UNCAMotorsports/TestMule/README.md

# RedBuggy
Software related to the "Red Buggy" / FSAE car for UNCA Motorsports
