UNCAMotorsports/TestMule/docs/Red Buggy Electrical Block Diagram.pdf

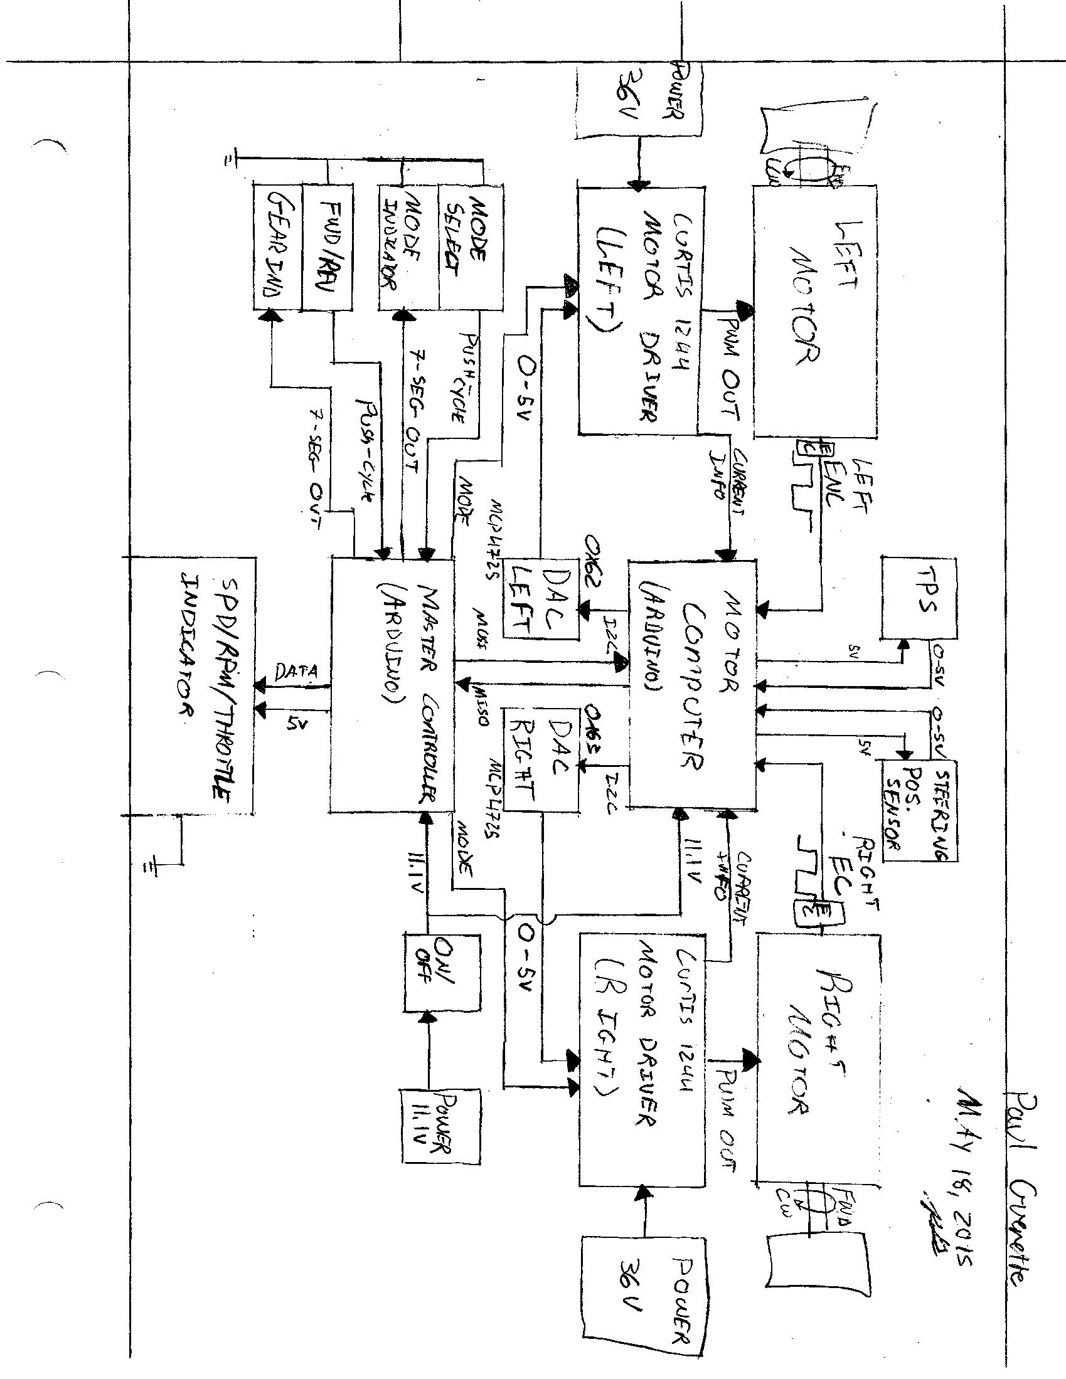
[picture p1: page 1]
