UNCAMotorsports/TestMule/schematics/Pictures/BuggyMotorBoard_Board001.png

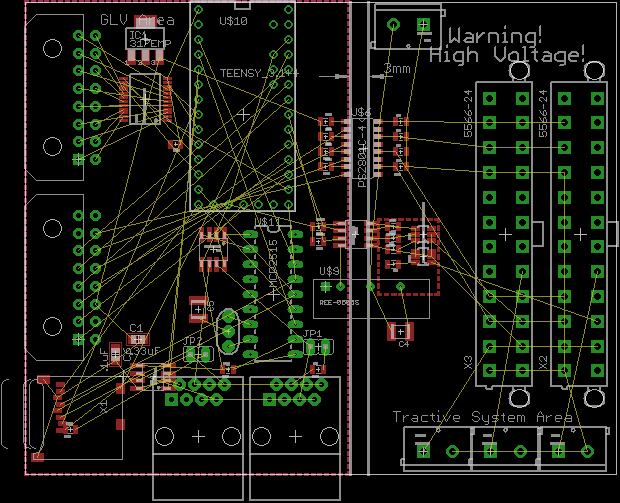
schematics/Pictures/BuggyMotorBoard_Board001.png
