UNCAMotorsports/TestMule/schematics/Pictures/BuggyMotorBoard_Schematic001.png

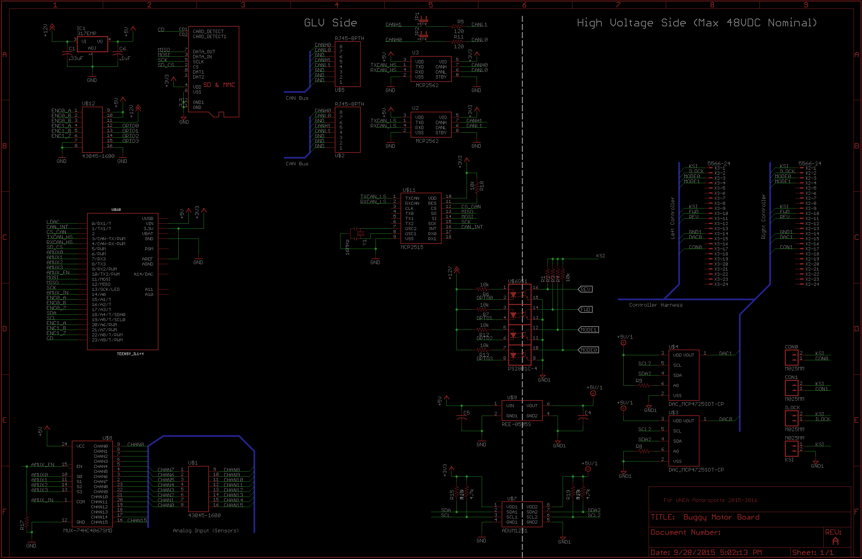
schematics/Pictures/BuggyMotorBoard_Schematic001.png
