UNCAMotorsports/TestMule/docs/Power Consumption.xlsx

 |  | Datasheet (Amps) |  | As Implemented (mA)
Part | Power Bus | Idd (Typ) | Idd (Max) | Typ | Max | Eff. Factor | Quantity
MCP4725 | 5v | 0.0002 | 0.0002 | 0.53 | 0.53 | 80% | 2
SD Card | 5v | 0.0400 | 0.1000 | 40.00 | 100.00 | 100% | 1
MCP2515 | 5v | 0.0100 | 0.0100 | 10.00 | 10.00 | 100% | 1
MCP2551 | 5v | 0.0900 | 0.0900 | 90.00 | 90.00 | 100% | 1
ADUM1251 | 5v | 0.0028 | 0.0050 | 2.80 | 5.00 | 100% | 1
Total |  | 0.1430 | 0.2052 | 143.33 | 205.53 |  | 6
