UNCAMotorsports/TestMule/schematics/Buggy Motor Board.pdf

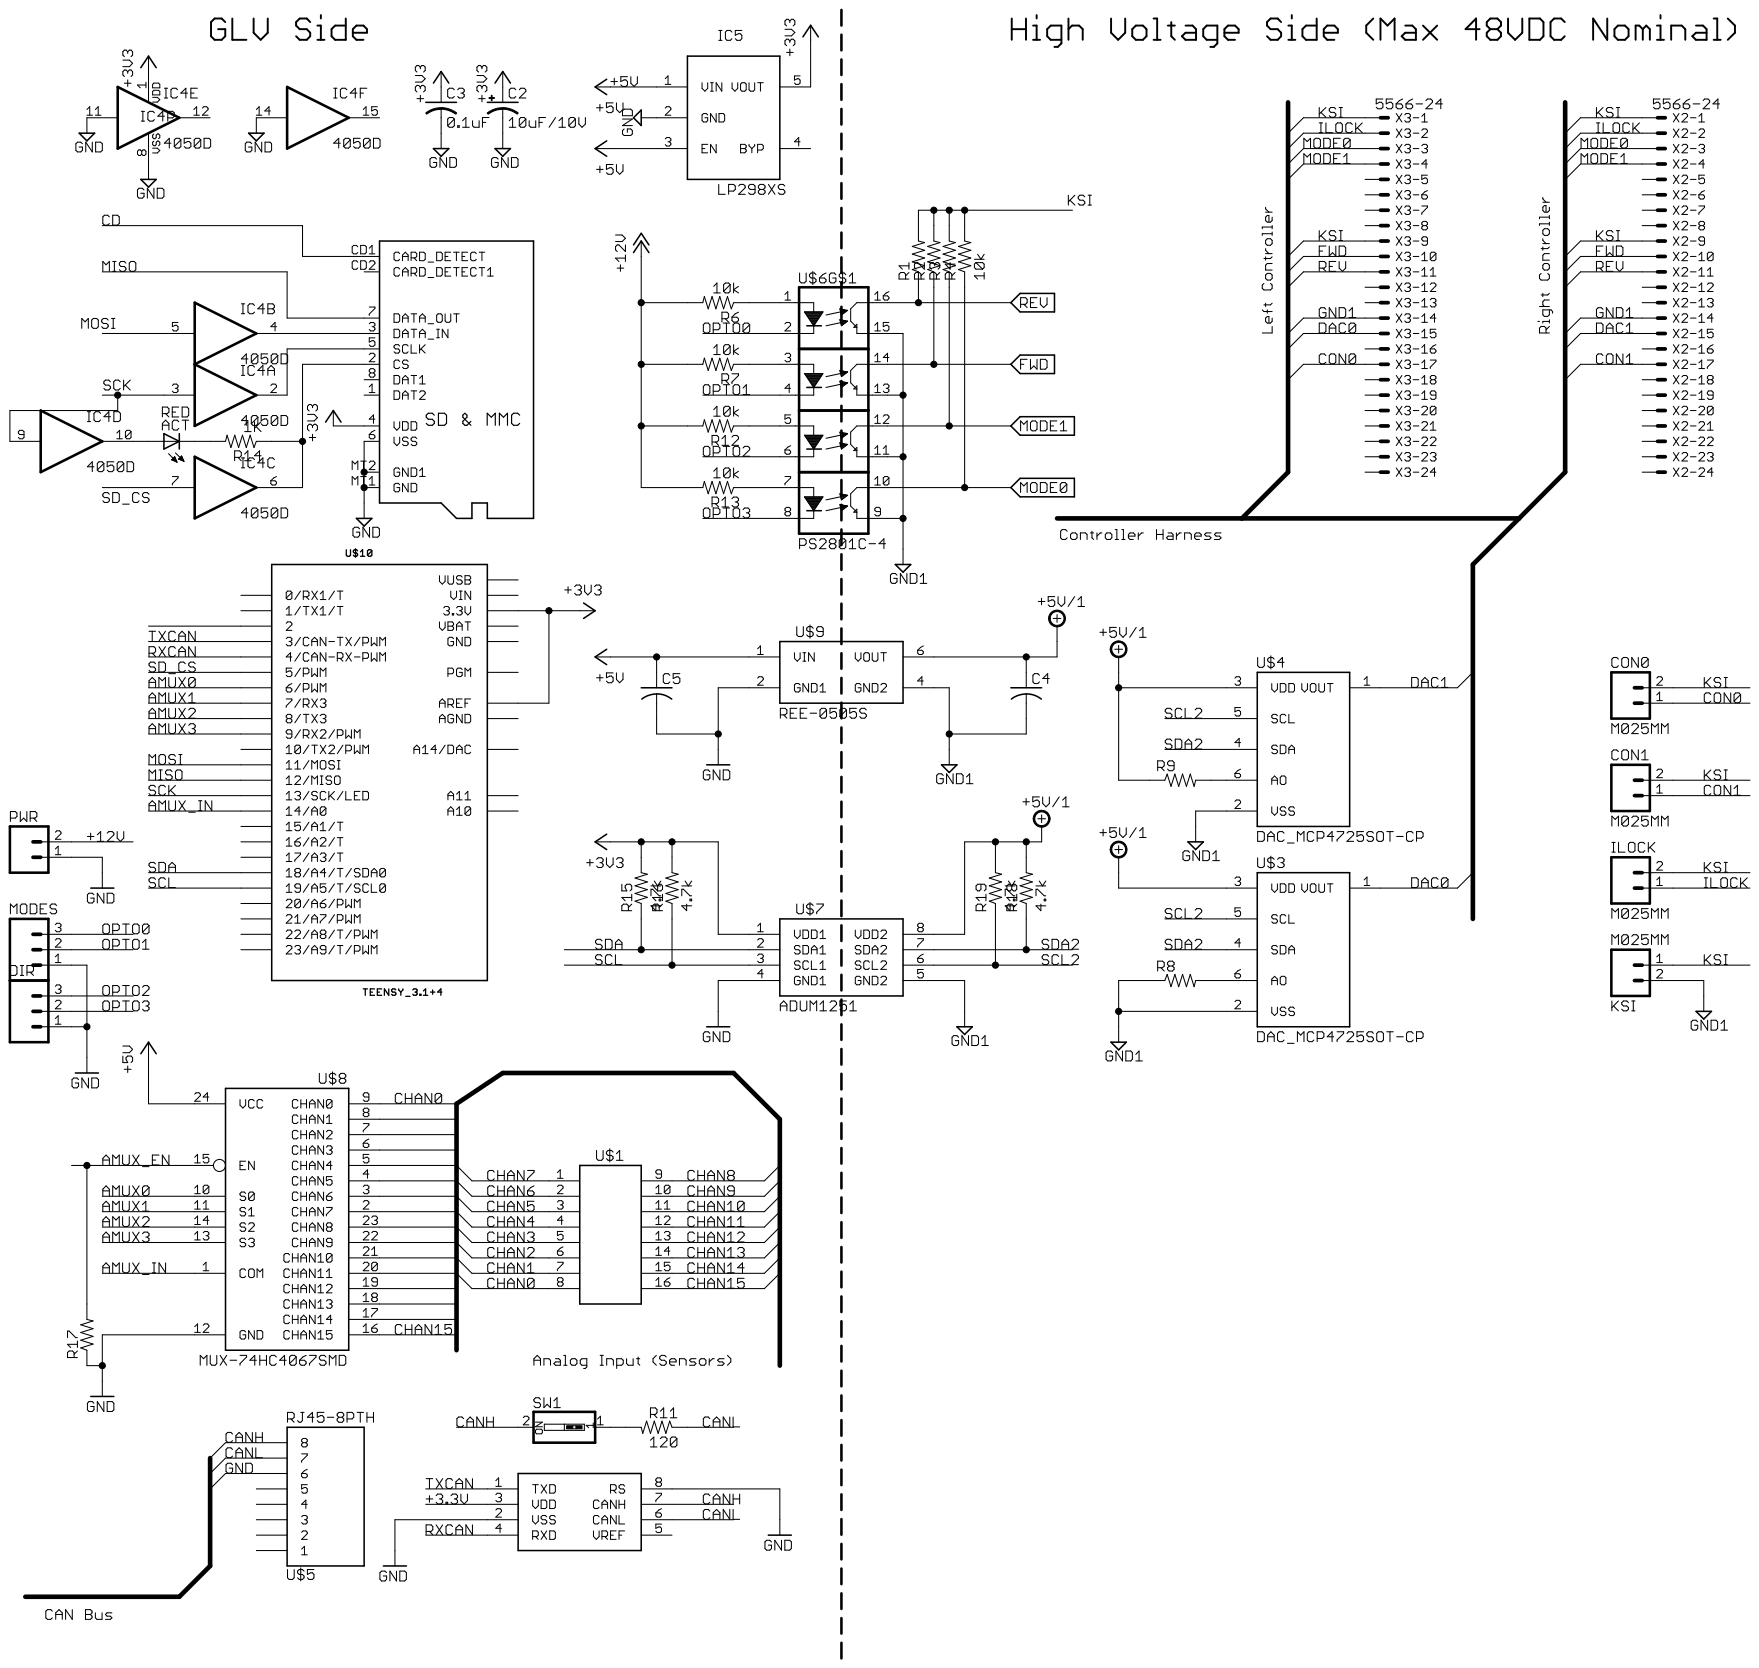
[picture p4: page 1]
