UNCAMotorsports/TestMule/docs/Red Buggy Schematic 2015.pdf

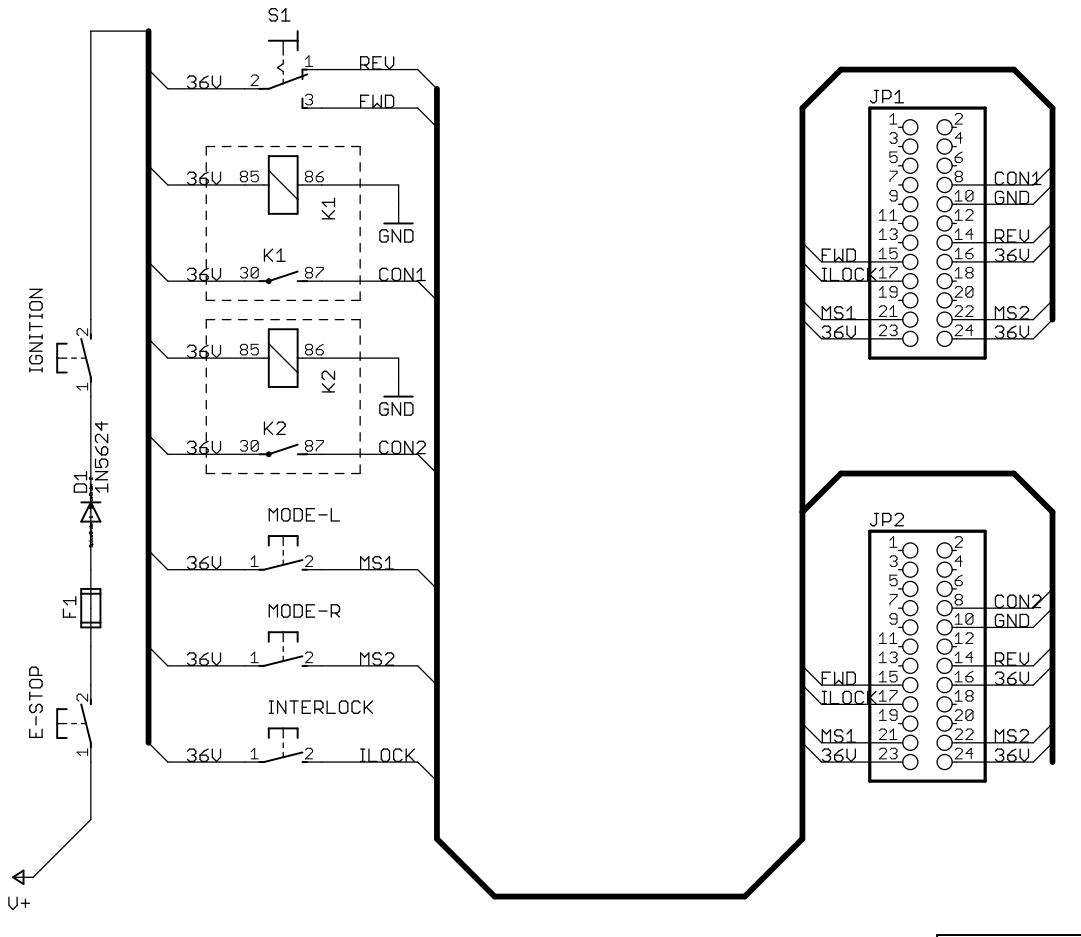
[picture p6: page 1]
