UNCAMotorsports/TestMule/docs/canbus_shield_rev_B.pdf

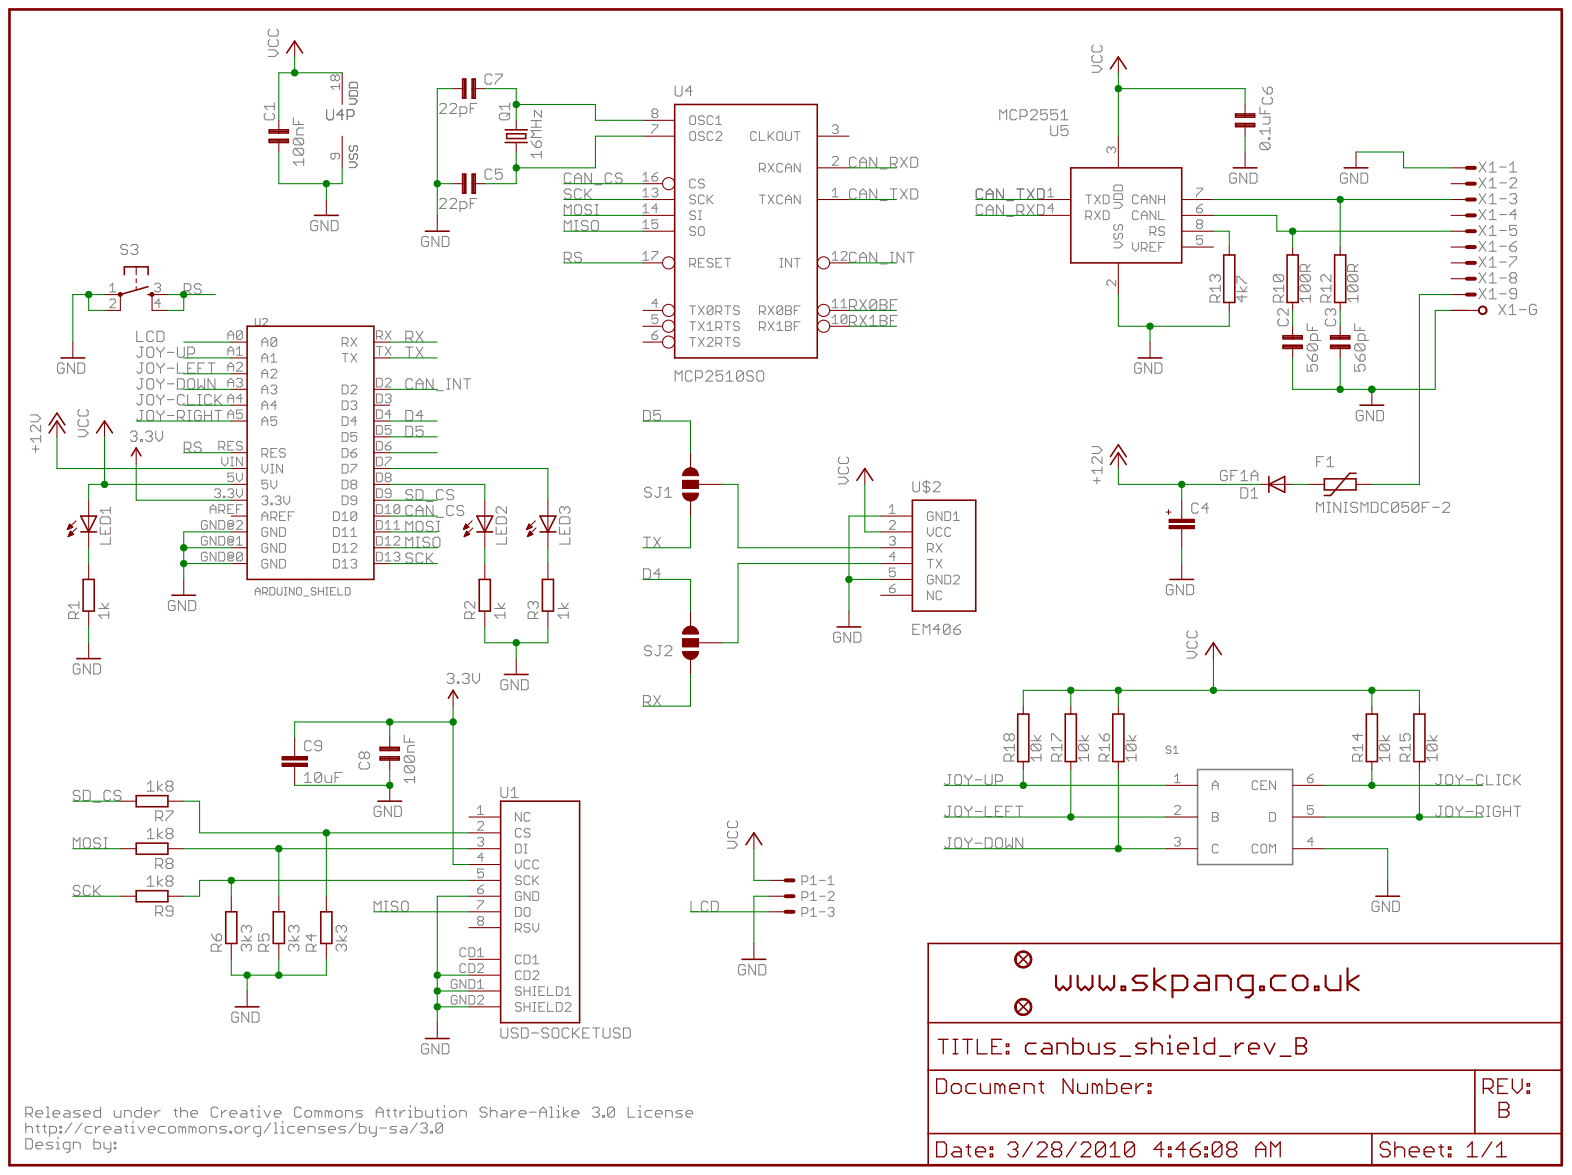
[picture p7: page 1]
