UNCAMotorsports/TestMule/schematics/Buggy Motor Board.brd

## EAGLE design schematics/Buggy Motor Board.brd (2015-10-18)

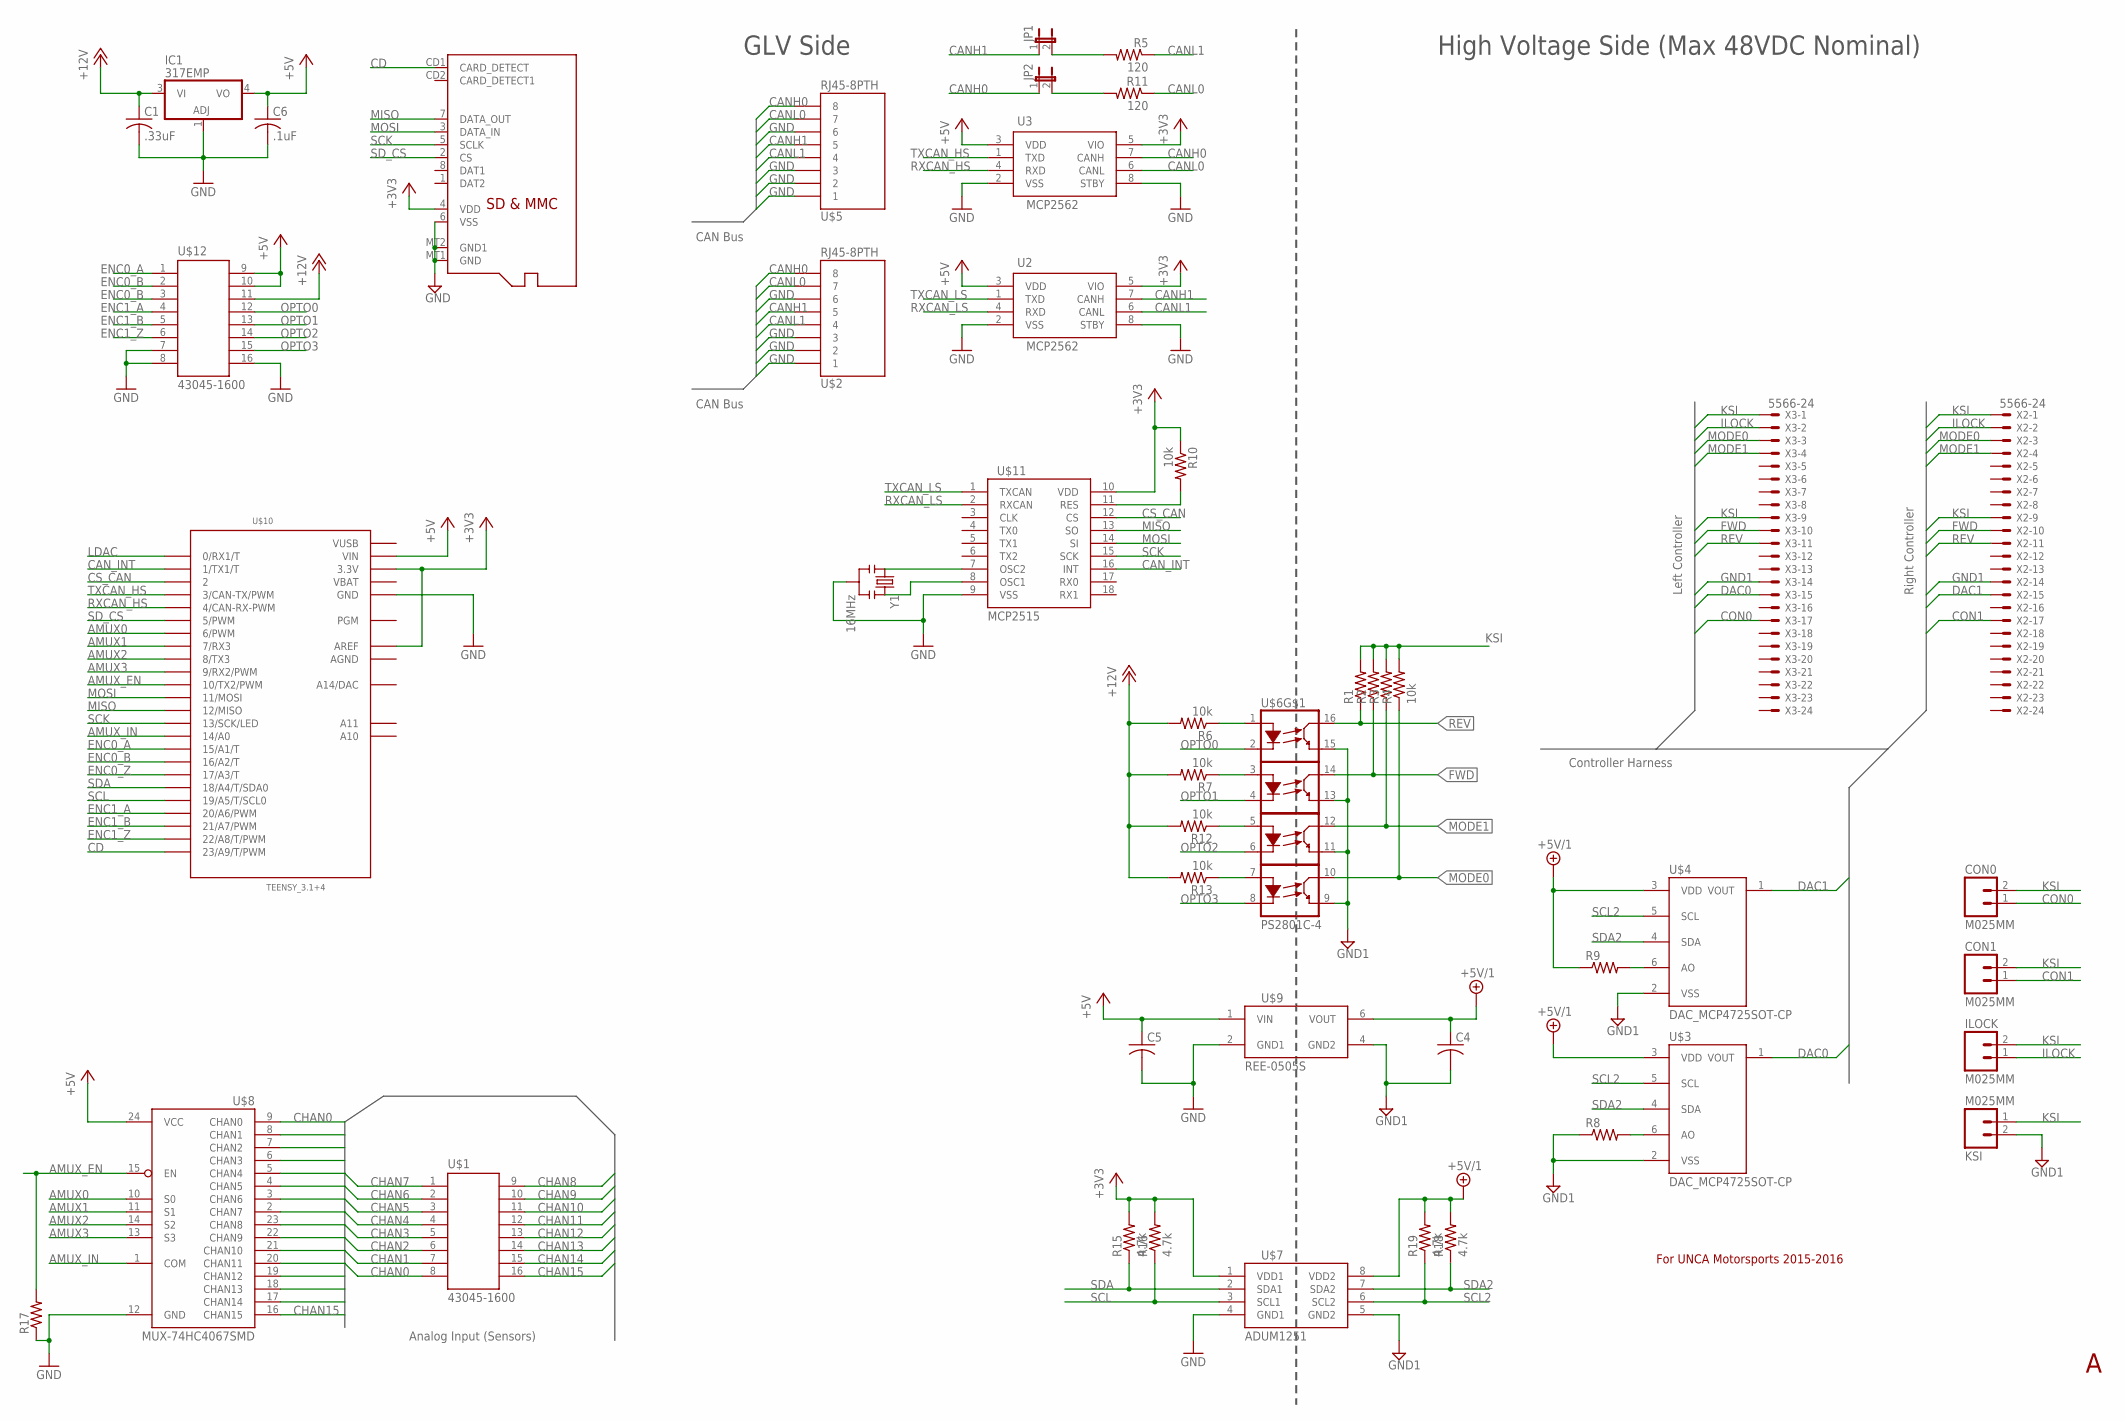
[picture p8: schematic Buggy Motor Board.sch]

Parts:
C1: .33uF; C0805
C4, C5: C-USC1210K; C1210K
C6: .1uF; C0805
CON0, CON1: M025MM; SCREWTERMINAL-5MM-2
IC1: 317EMP; SOT223
ILOCK: M025MM; SCREWTERMINAL-5MM-2
JP1, JP2: JP1E; JP1
KSI: M025MM; SCREWTERMINAL-5MM-2
R1, R2, R3, R8, R9, R17: RESISTOR0805-RES; 0805
R4, R6, R7, R10, R12, R13: 10k; 0805
R5, R11: 120; 0805
R15, R16, R18, R19: 4.7k; 0805
U2, U3: MCP2562; SO08
U$1, U$12: 43045-1600
U$2, U$5: RJ45-8PTH; RJ45-8
U$3, U$4: DAC_MCP4725SOT-CP; SOT23-6-MCP4725
U$6: PS2801C-4; 16-SOIC
U$7: ADUM1251; 8-SOIC
U$8: MUX-74HC4067SMD; SSOP24
U$9: REE-0505S
U$10: TEENSY_3.1+4
U$11: MCP2515; DIL18
X1: MICROSD
X2, X3: 5566-24
Y1: 16MHz; RESONATOR-PTH

Connections:
+3V3: R10.1, R15.2, R16.2, U2.5 (VIO), U3.5 (VIO), U$7.1 (VDD1), U$10.3.3V, U$10.3.3V1 (3.3V), U$10.AREF, U$11.10 (VDD), X1.4 (VDD)
+5V: C5.1, C6.1, IC1.4 (VO), U2.3 (VDD), U3.3 (VDD), U$8.24 (VCC), U$9.1 (VIN), U$10.VIN, U$12.9, U$12.10
+5V/1: C4.1, R9.1, R18.2, R19.2, U$3.3 (VDD), U$4.3 (VDD), U$7.8 (VDD2), U$9.6 (VOUT)
+12V: C1.1, IC1.3 (VI), R6.2, R7.2, R12.2, R13.2, U$12.11
AGND: U$10.AGND
AMUX0: U$8.10 (S0), U$10.6 (6/PWM)
AMUX1: U$8.11 (S1), U$10.7 (7/RX3)
AMUX2: U$8.14 (S2), U$10.8 (8/TX3)
AMUX3: U$8.13 (S3), U$10.9 (9/RX2/PWM)
AMUX_EN: R17.2, U$8.15 (EN), U$10.10 (10/TX2/PWM)
AMUX_IN: U$8.1 (COM), U$10.14/A0
CANH0: JP2.1, U3.7 (CANH), U$2.8, U$5.8
CANH1: JP1.1, U2.7 (CANH), U$2.5, U$5.5
CANL0: R11.1, U3.6 (CANL), U$2.7, U$5.7
CANL1: R5.1, U2.6 (CANL), U$2.4, U$5.4
CAN_INT: U$10.1 (1/TX1/T), U$11.16 (INT)
CD: U$10.23/A9 (23/A9/T/PWM), X1.CD1 (CARD_DETECT)
CHAN0: U$1.8, U$8.9 (CHAN0)
CHAN1: U$1.7, U$8.8 (CHAN1)
CHAN2: U$1.6, U$8.7 (CHAN2)
CHAN3: U$1.5, U$8.6 (CHAN3)
CHAN4: U$1.4, U$8.5 (CHAN4)
CHAN5: U$1.3, U$8.4 (CHAN5)
CHAN6: U$1.2, U$8.3 (CHAN6)
CHAN7: U$1.1, U$8.2 (CHAN7)
CHAN8: U$1.9, U$8.23 (CHAN8)
CHAN9: U$1.10, U$8.22 (CHAN9)
CHAN10: U$1.11, U$8.21 (CHAN10)
CHAN11: U$1.12, U$8.20 (CHAN11)
CHAN12: U$1.13, U$8.19 (CHAN12)
CHAN13: U$1.14, U$8.18 (CHAN13)
CHAN14: U$1.15, U$8.17 (CHAN14)
CHAN15: U$1.16, U$8.16 (CHAN15)
CON0: CON0.1, X3.17
CON1: CON1.1, X2.17
CS_CAN: U$10.2, U$11.12 (CS)
DAC0: U$3.1 (VOUT), X3.15
DAC1: U$4.1 (VOUT), X2.15
ENC0_A: U$10.15/A1 (15/A1/T), U$12.1
ENC0_B: U$10.16/A2 (16/A2/T), U$12.2
ENC0_Z: U$10.17/A3 (17/A3/T), U$12.3
ENC1_A: U$10.20/A6 (20/A6/PWM), U$12.4
ENC1_B: U$10.21/A7 (21/A7/PWM), U$12.5
ENC1_Z: U$10.22/A8 (22/A8/T/PWM), U$12.6
FWD: R2.1, U$6.14 (L1), X2.10, X3.10
GND: C1.2, C5.2, C6.2, IC1.1 (ADJ), R17.1, U2.2 (VSS), U2.8 (STBY), U3.2 (VSS), U3.8 (STBY), U$2.1, U$2.2, U$2.3, U$2.6, U$5.1, U$5.2, U$5.3, U$5.6, U$7.4 (GND1), U$8.12 (GND), U$9.2 (GND1), U$10.GND, U$10.GND1 (GND), U$11.9 (VSS), U$12.7, U$12.8, U$12.16, X1.6 (VSS), X1.MT1 (GND), X1.MT2 (GND1), Y1.2
GND1: C4.2, KSI.2, R8.1, U$3.2 (VSS), U$4.2 (VSS), U$6.9 (L2), U$6.11 (L2), U$6.13 (L2), U$6.15 (L2), U$7.5 (GND2), U$9.4 (GND2), X2.14, X3.14
ILOCK: ILOCK.1, X2.2, X3.2
KSI: CON0.2, CON1.2, ILOCK.2, KSI.1, R1.2, R2.2, R3.2, R4.2, X2.1, X2.9, X3.1, X3.9
LDAC: U$10.0 (0/RX1/T)
MISO: U$10.12 (12/MISO), U$11.13 (SO), X1.7 (DATA_OUT)
MODE0: R4.1, U$6.10 (L1), X2.3, X3.3
MODE1: R3.1, U$6.12 (L1), X2.4, X3.4
MOSI: U$10.11 (11/MOSI), U$11.14 (SI), X1.3 (DATA_IN)
unnamed: JP1.2, R5.2
unnamed: R8.2, U$3.6 (AO)
unnamed: R9.2, U$4.6 (AO)
unnamed: U$11.7 (OSC2), Y1.1
unnamed: U$11.8 (OSC1), Y1.3
unnamed: R6.1, U$6.1 (A)
unnamed: JP2.2, R11.2
unnamed: R10.2, U$11.11 (RES)
unnamed: R7.1, U$6.3 (A)
unnamed: R12.1, U$6.5 (A)
unnamed: R13.1, U$6.7 (A)
OPTO0: U$6.2 (C), U$12.12
OPTO1: U$6.4 (C), U$12.13
OPTO2: U$6.6 (C), U$12.14
OPTO3: U$6.8 (C), U$12.15
REV: R1.1, U$6.16 (L1), X2.11, X3.11
RXCAN_HS: U3.4 (RXD), U$10.4 (4/CAN-RX-PWM)
RXCAN_LS: U2.4 (RXD), U$11.2 (RXCAN)
SCK: U$10.13 (13/SCK/LED), U$11.15 (SCK), X1.5 (SCLK)
SCL: R16.1, U$7.3 (SCL1), U$10.19/A5 (19/A5/T/SCL0)
SCL2: R19.1, U$3.5 (SCL), U$4.5 (SCL), U$7.6 (SCL2)
SDA: R15.1, U$7.2 (SDA1), U$10.18/A4 (18/A4/T/SDA0)
SDA2: R18.1, U$3.4 (SDA), U$4.4 (SDA), U$7.7 (SDA2)
SD_CS: U$10.5 (5/PWM), X1.2 (CS)
TXCAN_HS: U3.1 (TXD), U$10.3 (3/CAN-TX/PWM)
TXCAN_LS: U2.1 (TXD), U$11.1 (TXCAN)
VBAT: U$10.VBAT
VUSB: U$10.VUSB

Notes on the sheet:
For UNCA Motorsports 2015-2016
Analog Input (Sensors)
CAN Bus
Controller Harness
Left Controller
Right Controller
High Voltage Side (Max 48VDC Nominal)
GLV Side

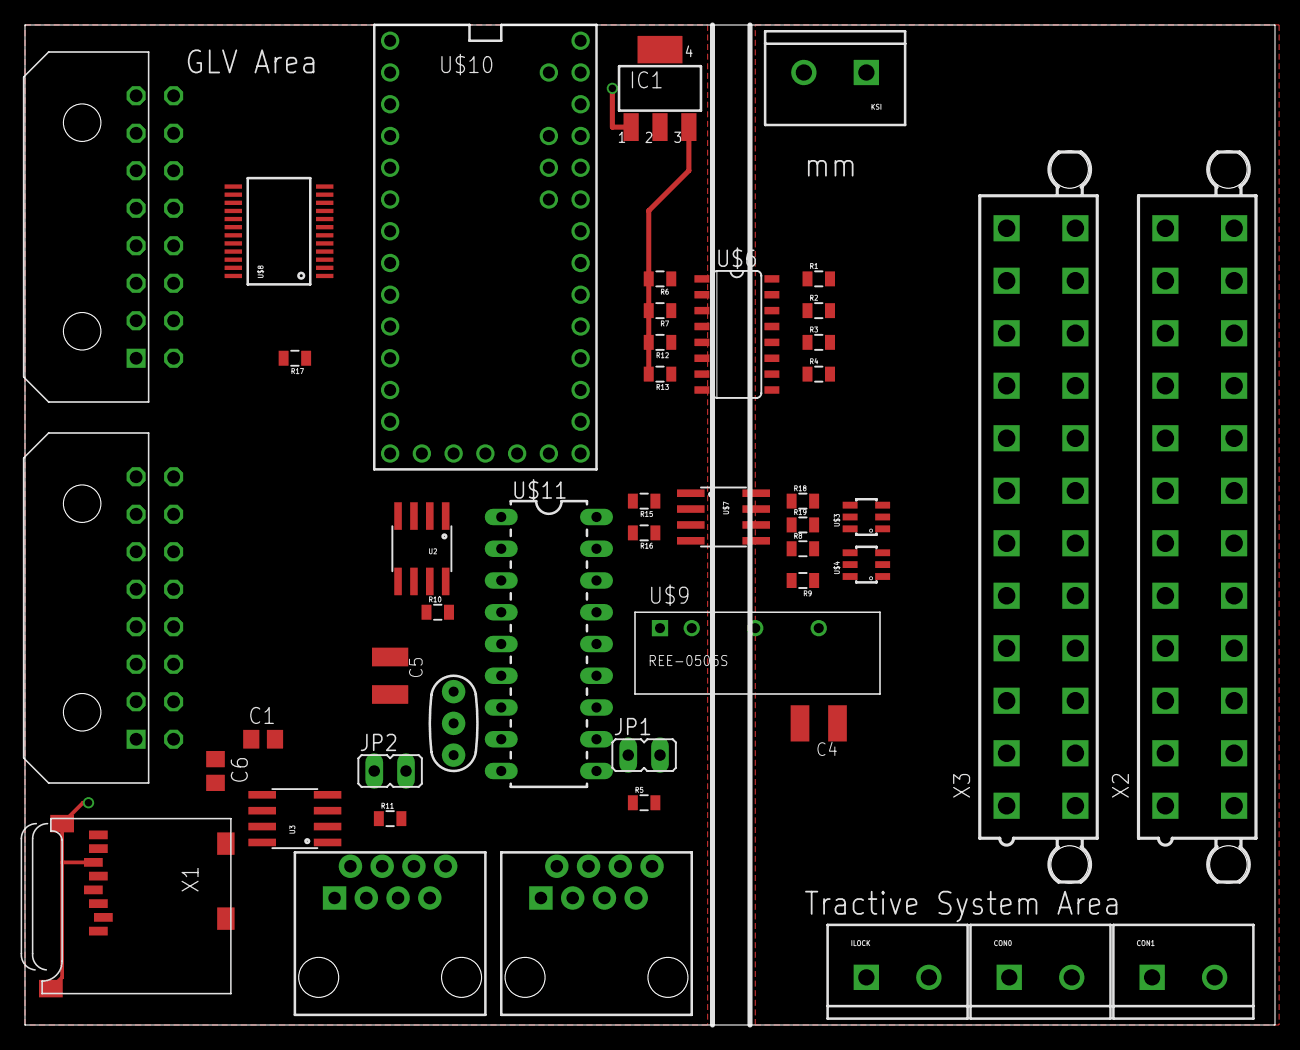
[picture p9: board Buggy Motor Board.brd from above]

Board: 2 copper layers, 100.0 x 80.0 mm, 47 parts (0 on the bottom side), 78 nets.
