UNCAMotorsports/TestMule/schematics/Red Buggy 2015.brd

## EAGLE design schematics/Red Buggy 2015.brd (2015-07-28)

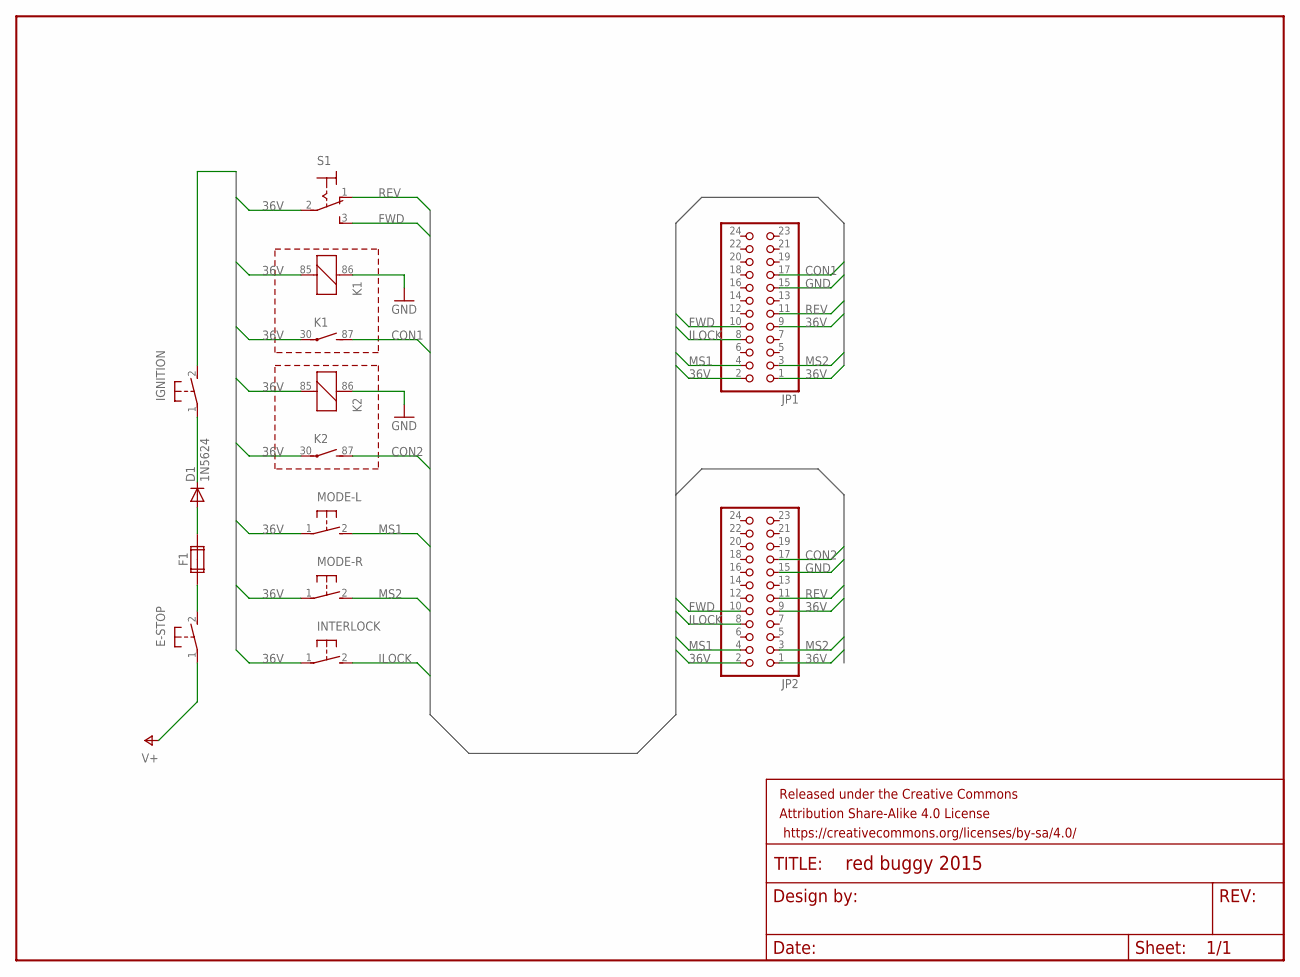
[picture p10: schematic Red Buggy 2015.sch]

Parts:
D1: 1N5624; DO201-15
E-STOP: 31-XX; B3F-31XX
F1: FUSE2P; FUSE1
FRAME1: FRAME-LETTER; CREATIVE_COMMONS
IGNITION: 31-XX; B3F-31XX
INTERLOCK: 31-XX; B3F-31XX
JP1, JP2: PINHD-2X12; 2X12
K1, K2: CB1A-P-12V; CB1
MODE-L: 31-XX; B3F-31XX
MODE-R: 31-XX; B3F-31XX
S1: 320-916

Connections:
36V: IGNITION.2 (S), INTERLOCK.1, JP1.1, JP1.2, JP1.9, JP2.1, JP2.2, JP2.9, K1.30, K1.85 (2), K2.30, K2.85 (2), MODE-L.1, MODE-R.1, S1.2
CON1: JP1.17, K1.87 (S)
CON2: JP2.17, K2.87 (S)
FWD: JP1.10, JP2.10, S1.3 (S)
GND: JP1.15, JP2.15, K1.86 (1), K2.86 (1)
ILOCK: INTERLOCK.2 (S), JP1.8, JP2.8
MS1: JP1.4, JP2.4, MODE-L.2 (S)
MS2: JP1.3, JP2.3, MODE-R.2 (S)
unnamed: D1.A, F1.2A
unnamed: E-STOP.2 (S), F1.1A
unnamed: D1.C, IGNITION.1
REV: JP1.11, JP2.11, S1.1 (O)
V+: E-STOP.1

Board: 2 copper layers, 13 parts (0 on the bottom side), 12 nets, no tracks yet.
