UNCAMotorsports/TestMule/(commit log)

2015-07-11 EAGLE Schematic init
    [Buggy Motor Board.brd, Buggy Motor Board.sch, New Buggy 2015.brd, New Buggy 2015.sch, Red Buggy 2015.brd, Red Buggy 2015.sch]
2015-07-11 Added shift register (TEST)
    [Buggy Motor Board.brd, Buggy Motor Board.sch]
2015-07-11 Added Screw Clamp (TEST)
    [Buggy Motor Board.brd, Buggy Motor Board.sch]
2015-07-12 CAN Bus testing (Send/recv)
2015-07-20 Add CAN support to schematic, high side drivers.
    [Buggy Motor Board.brd, Buggy Motor Board.sch]
2015-07-22 Add SD Card slot & level shifter
    [Buggy Motor Board.sch]
2015-07-24 Add analog multiplexer, shift register
    [Buggy Motor Board.sch]
2015-07-24 Add frame
    [Buggy Motor Board.sch]
2015-07-24 Optoisolators, MPU9150, cleanup
    [Buggy Motor Board.sch]
2015-07-24 Second shift register
    [Buggy Motor Board.sch]
2015-07-26 Second optocoupler
    [Buggy Motor Board.sch]
2015-07-26 Add molex connectors for curtis controllers
    [Buggy Motor Board.sch]
2015-07-28 Tweak for Red Buggy
    Removed IMU, second opto-coupler, shift registers; added connectors for
    Curtis motor controllers
    [Buggy Motor Board.sch, Red Buggy 2015.brd, Red Buggy 2015.sch]
2015-07-29 Start Board, improve isolation
    Started layout of board. Changed Optocoupler. Improved isolation by
    moving DACs to the high voltage side and providing an isolated 5v rail.
    Added Isolated I2C Converter to communicate with DACs across airgap.
    [Buggy Motor Board.brd, Buggy Motor Board.sch]
2015-08-02 Power consumption, analog input connectors
    [Buggy Motor Board.brd, Buggy Motor Board.sch, Power Consumption.xlsx]
2015-08-04 Replace Nano with Teensy 3.1
    [Buggy Motor Board.brd, Buggy Motor Board.sch]
2015-08-05 Add microfit connector
    [Buggy Motor Board.brd, Buggy Motor Board.sch]
2015-08-05 Microfit connector
    [Buggy Motor Board.brd, Buggy Motor Board.sch]
2015-08-07 5v Optocoupling
    [Buggy Motor Board.brd, Buggy Motor Board.sch]
2015-09-07 Pre-Share Update
    [Buggy Motor Board.brd, Buggy Motor Board.sch]
2015-09-08 Remove 3v3 level shifter, add encoder inputs
    [Buggy Motor Board.brd, Buggy Motor Board.sch]
2015-09-08 Move some stuff around
    [Buggy Motor Board.brd, Buggy Motor Board.sch, New Buggy 2015.brd, New Buggy 2015.sch, Red Buggy 2015.brd, Red Buggy 2015.sch]
2015-09-08 Tweak for Master
    [Buggy Motor Board.brd, Buggy Motor Board.sch]
2015-09-08 Add Quadrature Counter, RTC, MPU, CAN Bus 2
    [Buggy Motor Board.brd, Buggy Motor Board.sch]
2015-09-12 Schematic changes
    [Buggy Motor Board.brd, Buggy Motor Board.sch, New Buggy 2015.brd, New Buggy 2015.sch]
2015-09-12 Implement steering code
2015-09-20 Teensy changes, working code
2015-09-26 Debug defines
    [TestMule 2015.sch]
2015-10-18 Tested to be working with motors
    [Buggy Motor Board.brd, Buggy Motor Board.sch]
2016-03-02 Fix Encoder conversion
2016-03-02 Move steering into its own function
2016-03-03 Minor loop timing fixes
    [TestMule.ino]
2016-03-07 Setup encoder inputs
2016-03-26 Fix some debug formatting
    [TestMule.ino]
2016-03-26 Don't track VS data
2016-03-26 Remove binaries and hard to track files
2016-03-26 Test on Mule, fix SD
    [TestMule.ino]
2016-03-31 Start Torque Vectoring code
2016-03-31 Implement Torque Vectoring
2016-03-31 Add Data logging, torque vectoring
2016-04-09 Sensor & logging tweaks
2016-04-11 Fixes to get new code working correctly
    [MuleThrottle.cpp, TestMule.ino]
2016-08-18 Add Global Clock, fix steerAngle error
    [TestMule.ino]
2016-08-23 Moving avg filter of speed
2016-09-25 Added MCP47FEBXX datasheet (dual i2c dac)
